JulienGuitter/Spider/README.md

Un projet pour but, de faire se déplacer un robot araignée grace à un site internet, et d'un retour vidéo en temps réel

[Compte Rendu](Compte_Rendu_Guitter_Julien.pdf)
