JulienGuitter/Spider/(list of files, drawings)

Other design files:
Altium/Spider - ble/Borne.SchDoc
Altium/Spider - ble/ESPCamConnecter.SchDoc
Altium/Spider - ble/Leg.SchDoc
Altium/Spider - ble/LegControleur.SchDoc
Altium/Spider - ble/MainPCB.PcbDoc
Altium/Spider - ble/MainSchema.SchDoc
Altium/Spider - ble/Raspberry.SchDoc
Altium/Spider - ble/ShieldUart.SchDoc
Altium/Spider - ble/Spider_BLE.PrjPcb
Altium/Spider - Borne/Borne.SchDoc
Altium/Spider - Borne/ESPCamConnecter.SchDoc
Altium/Spider - Borne/Leg.SchDoc
Altium/Spider - Borne/LegControleur.SchDoc
Altium/Spider - Borne/MainPCB.PcbDoc
Altium/Spider - Borne/MainSchema.SchDoc
Altium/Spider - Borne/Raspberry.SchDoc
Altium/Spider - Borne/ShieldUart.SchDoc
Altium/Spider - Borne/Spider_BORNE.PrjPcb
Altium/Spider - ESPCam/Borne.SchDoc
Altium/Spider - ESPCam/ESPCamConnecter.SchDoc
Altium/Spider - ESPCam/Leg.SchDoc
Altium/Spider - ESPCam/LegControleur.SchDoc
Altium/Spider - ESPCam/MainPCB.PcbDoc
Altium/Spider - ESPCam/MainSchema.SchDoc
Altium/Spider - ESPCam/Raspberry.SchDoc
Altium/Spider - ESPCam/ShieldUart.SchDoc
Altium/Spider - ESPCam/Spider_ESPCAM.PrjPcb
Altium/Spider - Leg/Borne.SchDoc
Altium/Spider - Leg/ESPCamConnecter.SchDoc
Altium/Spider - Leg/Leg.SchDoc
Altium/Spider - Leg/LegControleur.SchDoc
Altium/Spider - Leg/MainPCB.PcbDoc
Altium/Spider - Leg/MainSchema.SchDoc
Altium/Spider - Leg/Raspberry.SchDoc
Altium/Spider - Leg/ShieldUart.SchDoc
Altium/Spider - Leg/Spider_LEG.PrjPcb
Altium/Spider - motor/LegControleur.SchDoc
Altium/Spider - motor/MainPCB.PcbDoc
Altium/Spider - motor/MainSchema.SchDoc
Altium/Spider - motor/Spider_MOTOR.PrjPcb
Altium/Spider - ShieldUart/MainPCB.PcbDoc
Altium/Spider - ShieldUart/MainSchema.SchDoc
Altium/Spider - ShieldUart/ShieldUart.SchDoc
Altium/Spider - ShieldUart/Spider_SHIELDUART.PrjPcb
Altium/Spider/Borne.SchDoc
Altium/Spider/ESPCamConnecter.SchDoc
Altium/Spider/Leg.SchDoc
Altium/Spider/LegControleur.SchDoc
Altium/Spider/MainPCB.PcbDoc
Altium/Spider/MainSchema.SchDoc
Altium/Spider/Raspberry.SchDoc
Altium/Spider/ShieldUart.SchDoc
Altium/Spider/Spider.PrjPcb
