JulienGuitter/Spider/(commit log)

2023-11-17 add base project
    [Borne.SchDoc, ESPCamConnecter.SchDoc, Leg.SchDoc, LegControleur.SchDoc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]
2024-01-27 Clean file
    [MainPCB.GBL, MainPCB.GBO, MainPCB.GBP, MainPCB.GBS, MainPCB.GKO, MainPCB.GM1, MainPCB.GTL, MainPCB.GTO]
